evnchn-agentic/f95d-21700-charger/output/preview_detail.png

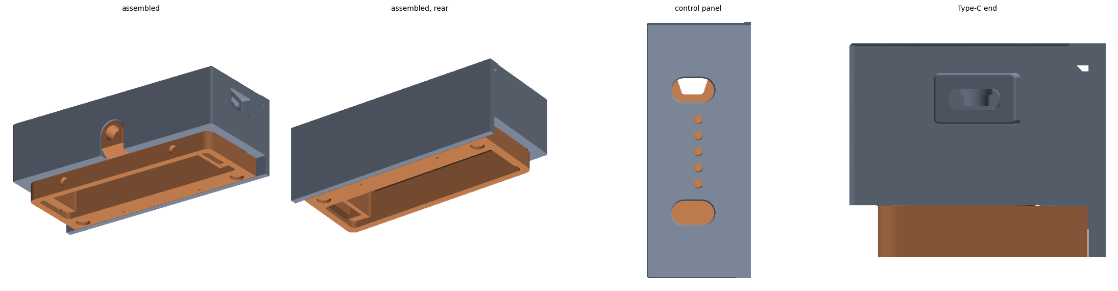
output/preview_detail.png
