evnchn-agentic/f95d-21700-charger/output/preview_faces.png

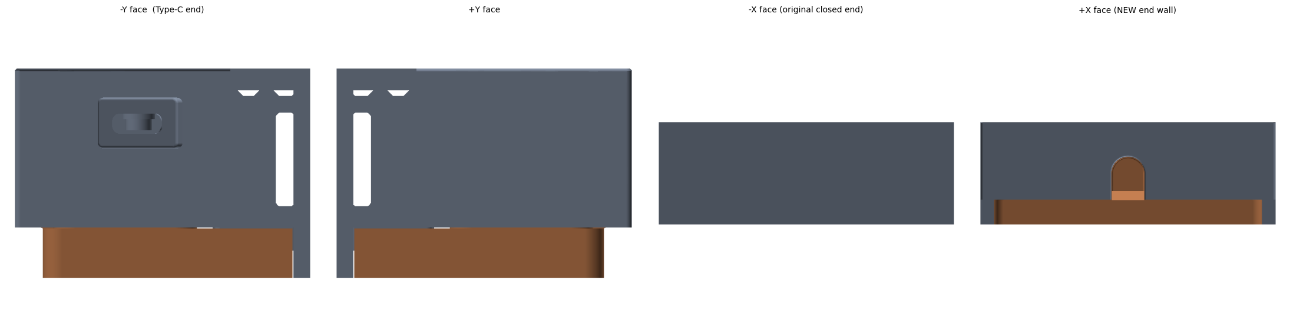
output/preview_faces.png
