evnchn-agentic/f95d-21700-charger/output/preview_panel_sealed.png

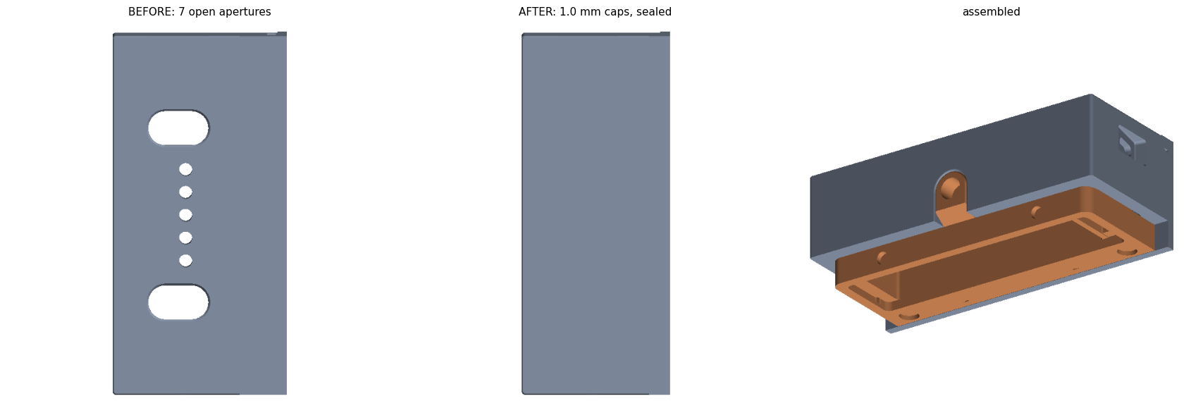
output/preview_panel_sealed.png
