evnchn-agentic/f95d-21700-charger/output/preview_short_bosses.png

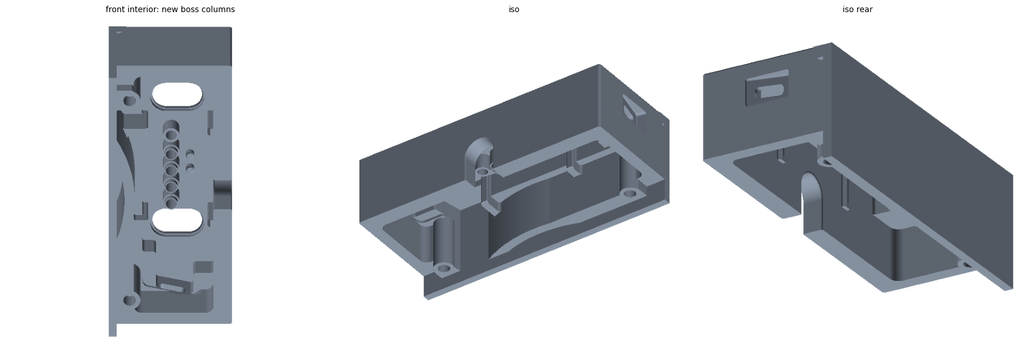
output/preview_short_bosses.png
