evnchn-agentic/f95d-21700-charger/output/preview_short_vs_long.png

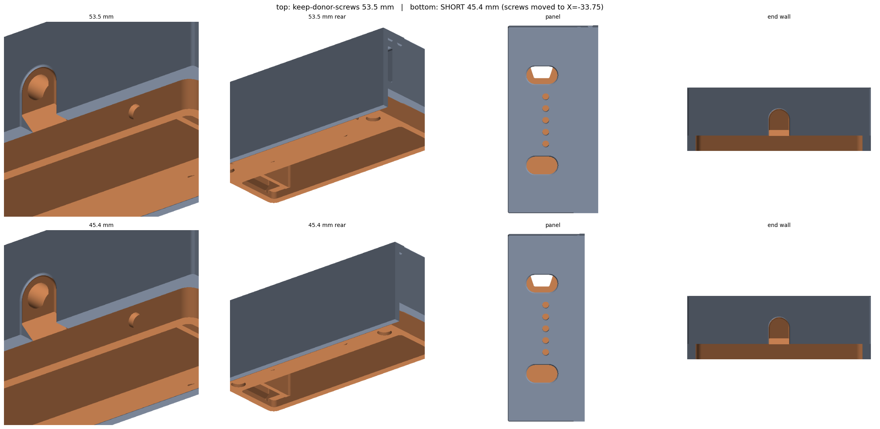
output/preview_short_vs_long.png
