evnchn-agentic/f95d-21700-charger/2_charger_back.3mf

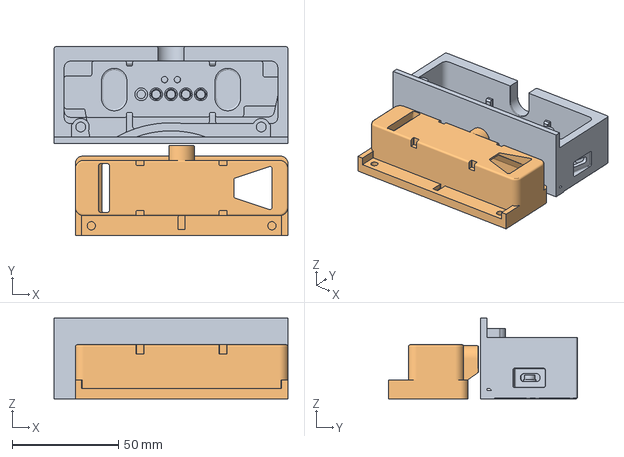
[picture p7: CAD file, 2026-08-11]
2_charger_back.3mf
110.0 x 88.7 x 38.0 mm
01_front_shell.stl
02_back_shell.stl
