evnchn-agentic/f95d-21700-charger/print/02_back_shell.stl

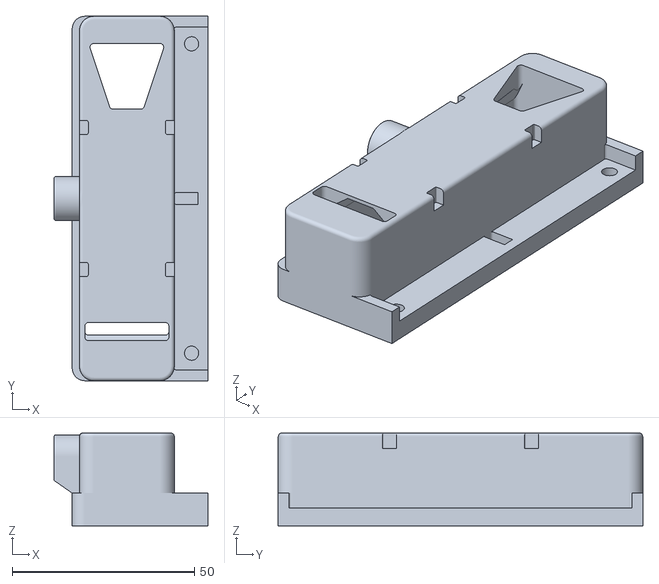
[picture p8: CAD file, 2026-08-11]
print/02_back_shell.stl
42.2 x 100.0 x 25.5
