evnchn-agentic/f95d-21700-charger/source-frames/donor-parts-reused-unmodified/battery_door_B.stl

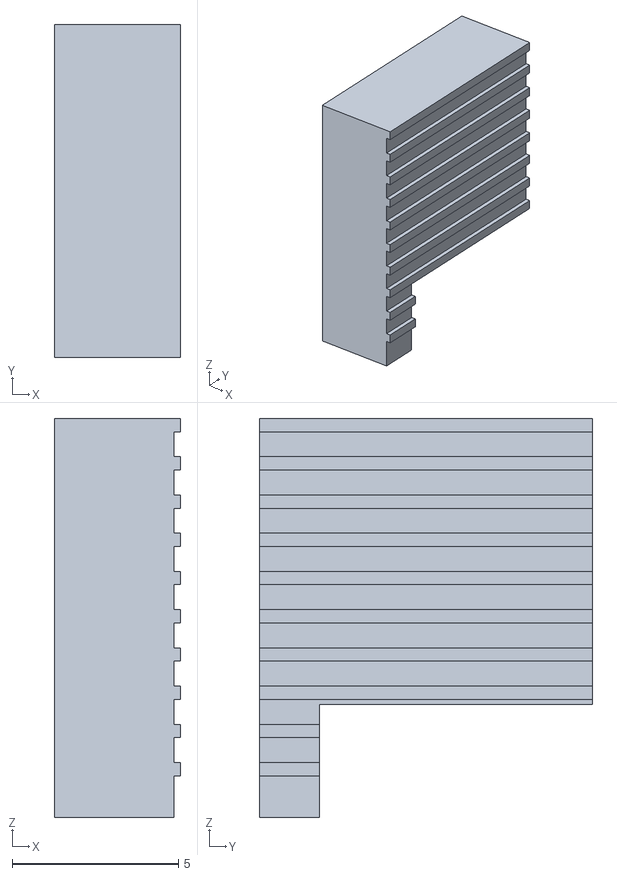
[picture p9: CAD file, 2026-08-11]
source-frames/donor-parts-reused-unmodified/battery_door_B.stl
3.80 x 10.0 x 12.0
