evnchn-agentic/f95d-21700-charger/print/03_battery_door.stl

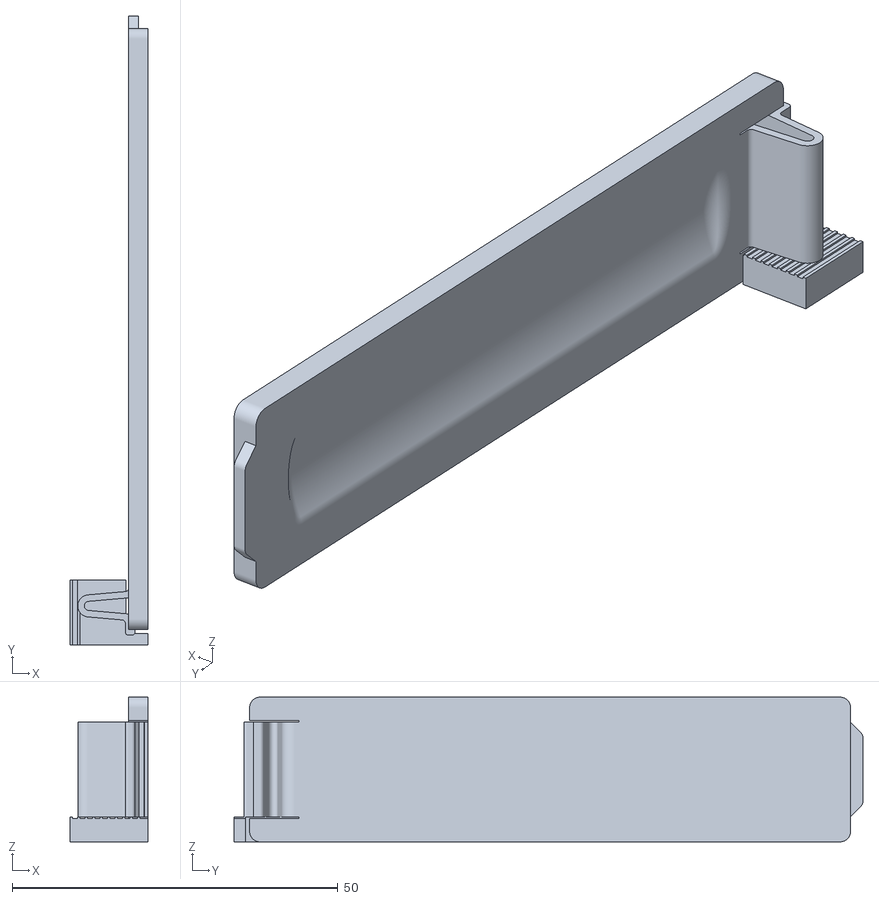
[picture p10: CAD file, 2026-08-11]
print/03_battery_door.stl
12.0 x 96.5 x 22.2
