evnchn-agentic/f95d-21700-charger/source-frames/1_charger_front.stl

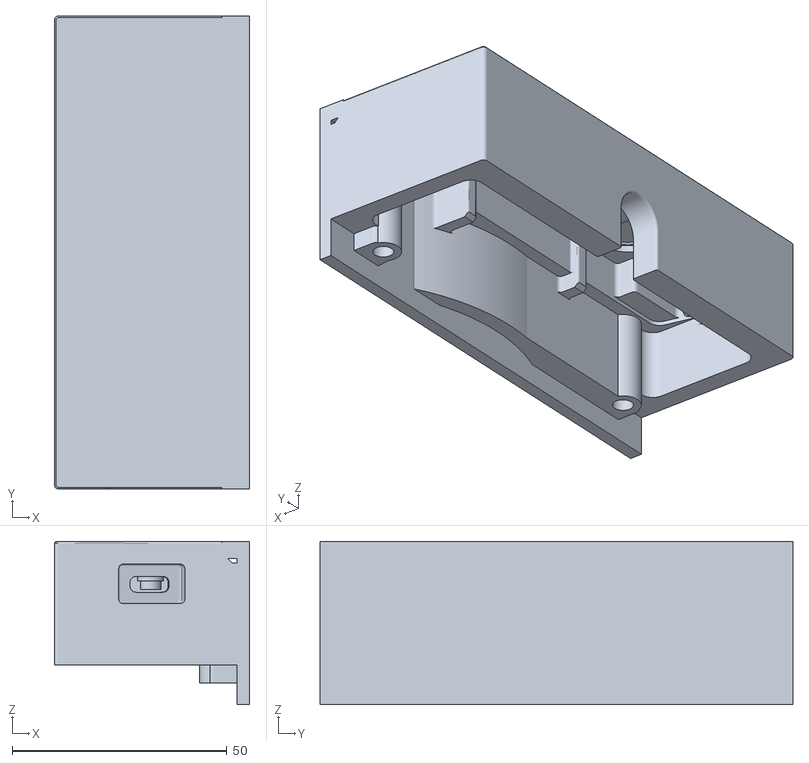
[picture p11: CAD file, 2026-08-11]
source-frames/1_charger_front.stl
45.4 x 110.0 x 38.0
