evnchn-agentic/f95d-21700-charger/source-frames/donor-parts-reused-unmodified/battery_door_A.stl

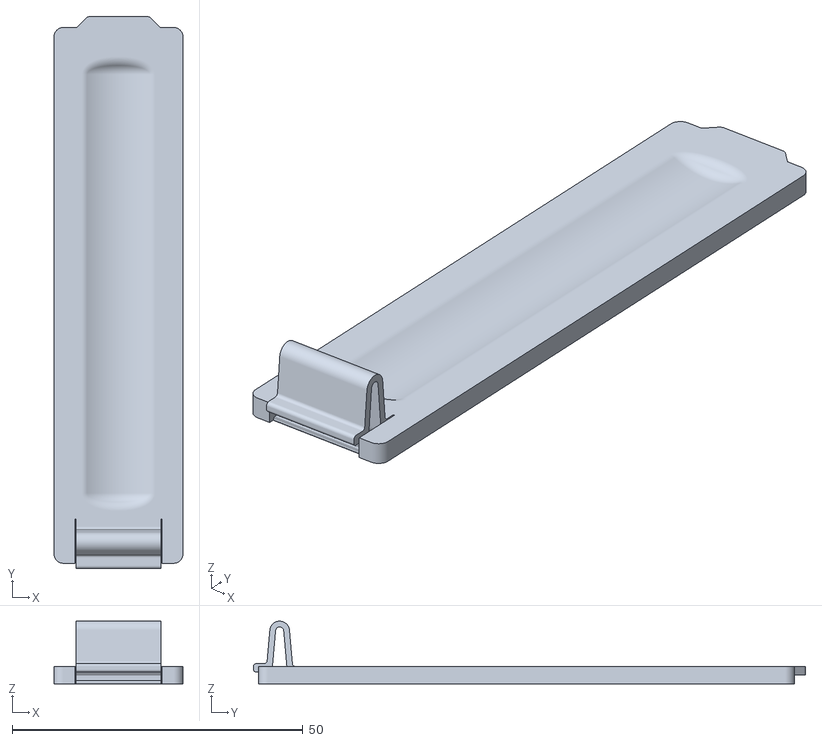
[picture p12: CAD file, 2026-08-11]
source-frames/donor-parts-reused-unmodified/battery_door_A.stl
22.2 x 95.0 x 10.8
