evnchn-agentic/f95d-21700-charger/alt-53.5mm-donor-screws/2b_charger_back_printed-in_support.stl

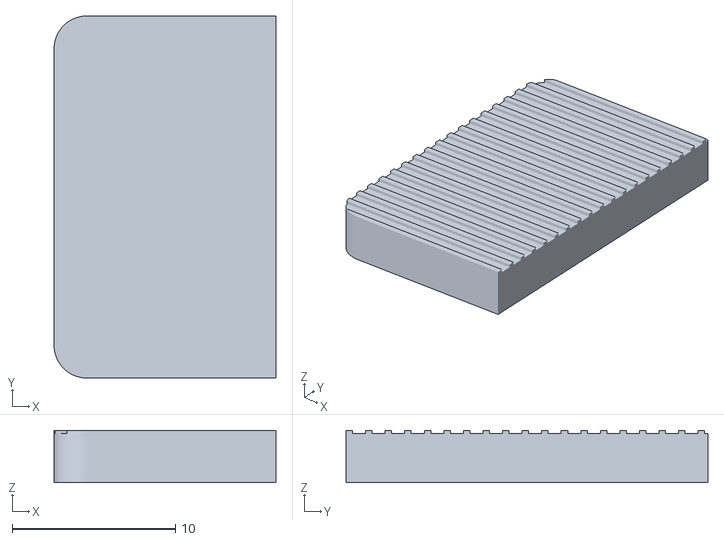
[picture p13: CAD file, 2026-08-11]
alt-53.5mm-donor-screws/2b_charger_back_printed-in_support.stl
13.6 x 22.2 x 3.20
