evnchn-agentic/f95d-21700-charger/alt-53.5mm-donor-screws/2_charger_back.stl

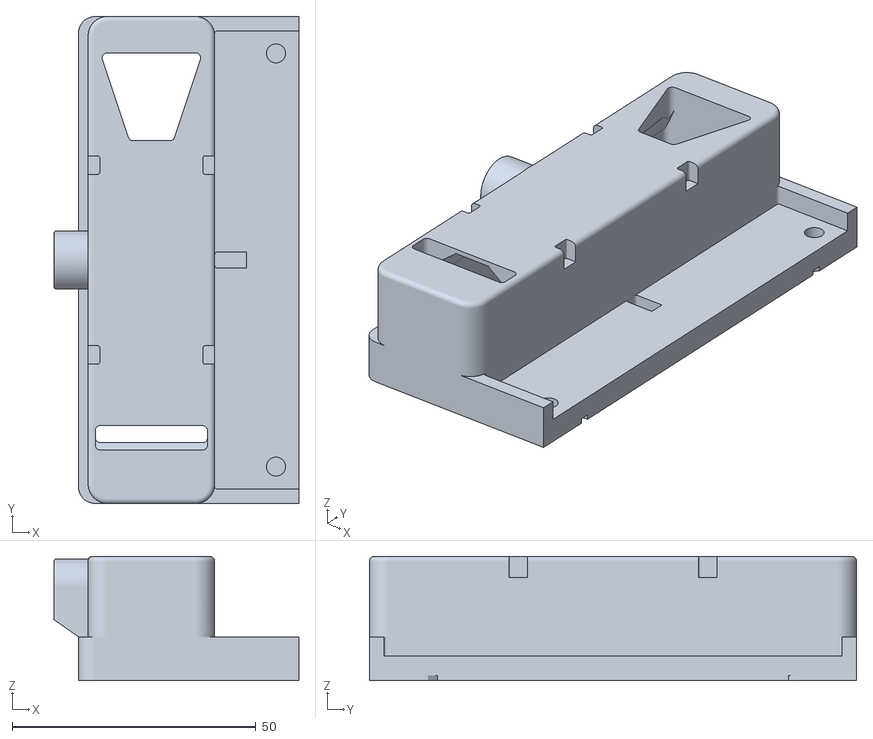
[picture p14: CAD file, 2026-08-11]
alt-53.5mm-donor-screws/2_charger_back.stl
50.3 x 100.0 x 25.5
