evnchn-agentic/f95d-21700-charger/alt-53.5mm-donor-screws/1_charger_front.stl

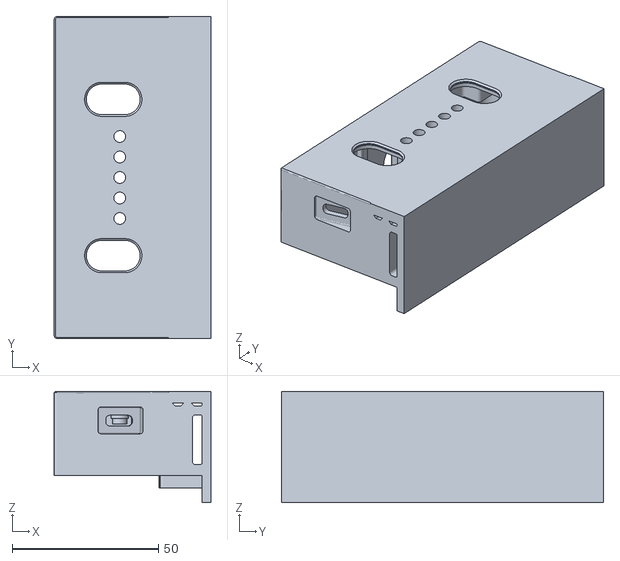
[picture p15: CAD file, 2026-08-11]
alt-53.5mm-donor-screws/1_charger_front.stl
53.5 x 110.0 x 38.0
