evnchn-agentic/f95d-21700-charger/(list of files, cad)

Other CAD files:
source-frames/2_charger_back.stl
ALL.3mf
print/01_front_shell.stl
