evnchn-agentic/f95d-21700-charger/(commit log)

2026-08-11 F95D fan housing -> 21700 USB-C charger
    Remix of 共田F95D风扇外壳 (李李子, MakerWorld): delete the fan bay, keep the control
    strip, relocate the M3 screw pair, seal the panel. 143 -> 45.4 mm assembled.
    Electronics bay preserved against the donor to 0.000000 mm on the back shell.
    33 verification checks; printed and confirmed working.
    [01_front_shell.stl, 02_back_shell.stl, 03_battery_door.stl, 1_charger_front.stl, 2_charger_back.3mf, 2_charger_back.stl, 2b_charger_back_printed-in_support.stl, ALL.3mf]
2026-08-11 NOTICE: state redistribution scope accurately
    The battery door IS redistributed - the build needs it to close the cell bay.
    Drop the button and light-pipe STLs: the panel is sealed, so they are unused.
    [light_pipe_clear-PETG.stl, switch_button.stl]
2026-08-11 De-brick: it was printed and it works
    The 拋磚引玉 framing claimed a rough first pass inviting refinement. That is not
    what this is - it was assembled and it charges. Keep the agent/human credit split,
    drop the draft status, and name the one real limitation (5000 mAh) instead.
2026-10-27 Make the build re-runnable from a clean checkout (#1)
    * Make the build re-runnable from a clean checkout
    build_charger_short.py loaded stl/front1.stl and stl/back_cover.stl,
    which were never committed, so the 33-check verification could not be
    re-run by anyone. Load the two donor parts straight from the donor 3MF
    instead; the rebuilt shells match source-frames/ exactly.
    Also:
    - zcol() crashed when a ray hits nothing: trimesh returns a 1-D empty
    array then. Reshape before indexing.
    - make_print_folder.py wrote to ~/f95d-21700-charger/print (rmtree
    first) wherever it was run from, and its ~/Downloads/*F95D*.3mf glob
    could pick a different revision whose object ids do not match. Write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
